ConnorRigby/underglow3/WiringHarness/resources/JST-SM-01x04-Male.png

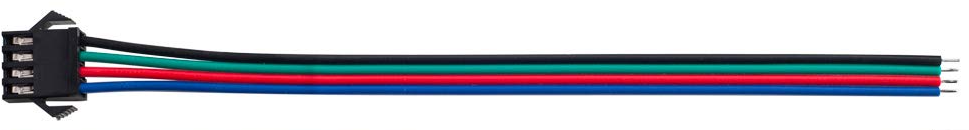
WiringHarness/resources/JST-SM-01x04-Male.png
