ConnorRigby/underglow3/WiringHarness/resources/Strip.png

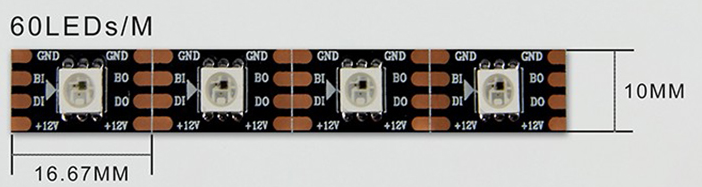
WiringHarness/resources/Strip.png
