ConnorRigby/underglow3/MainBoard/silk.png

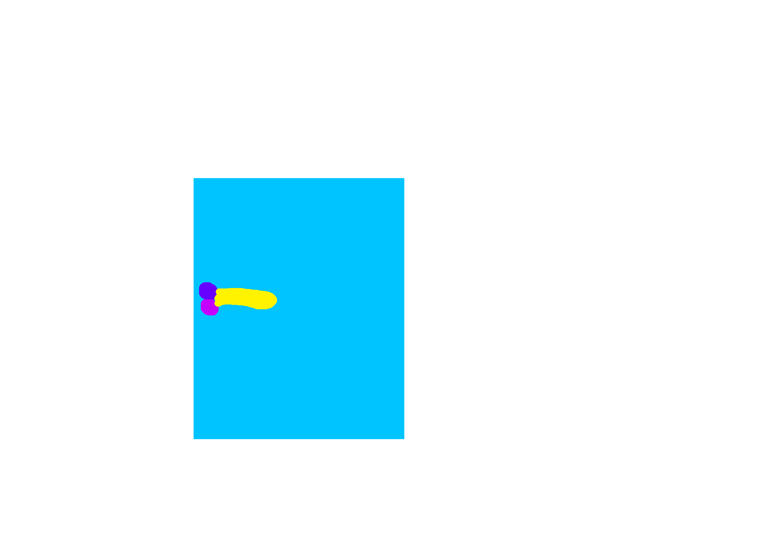
MainBoard/silk.png
