ConnorRigby/underglow3/MainBoard/underglow3-F_Silkscreen-1.png

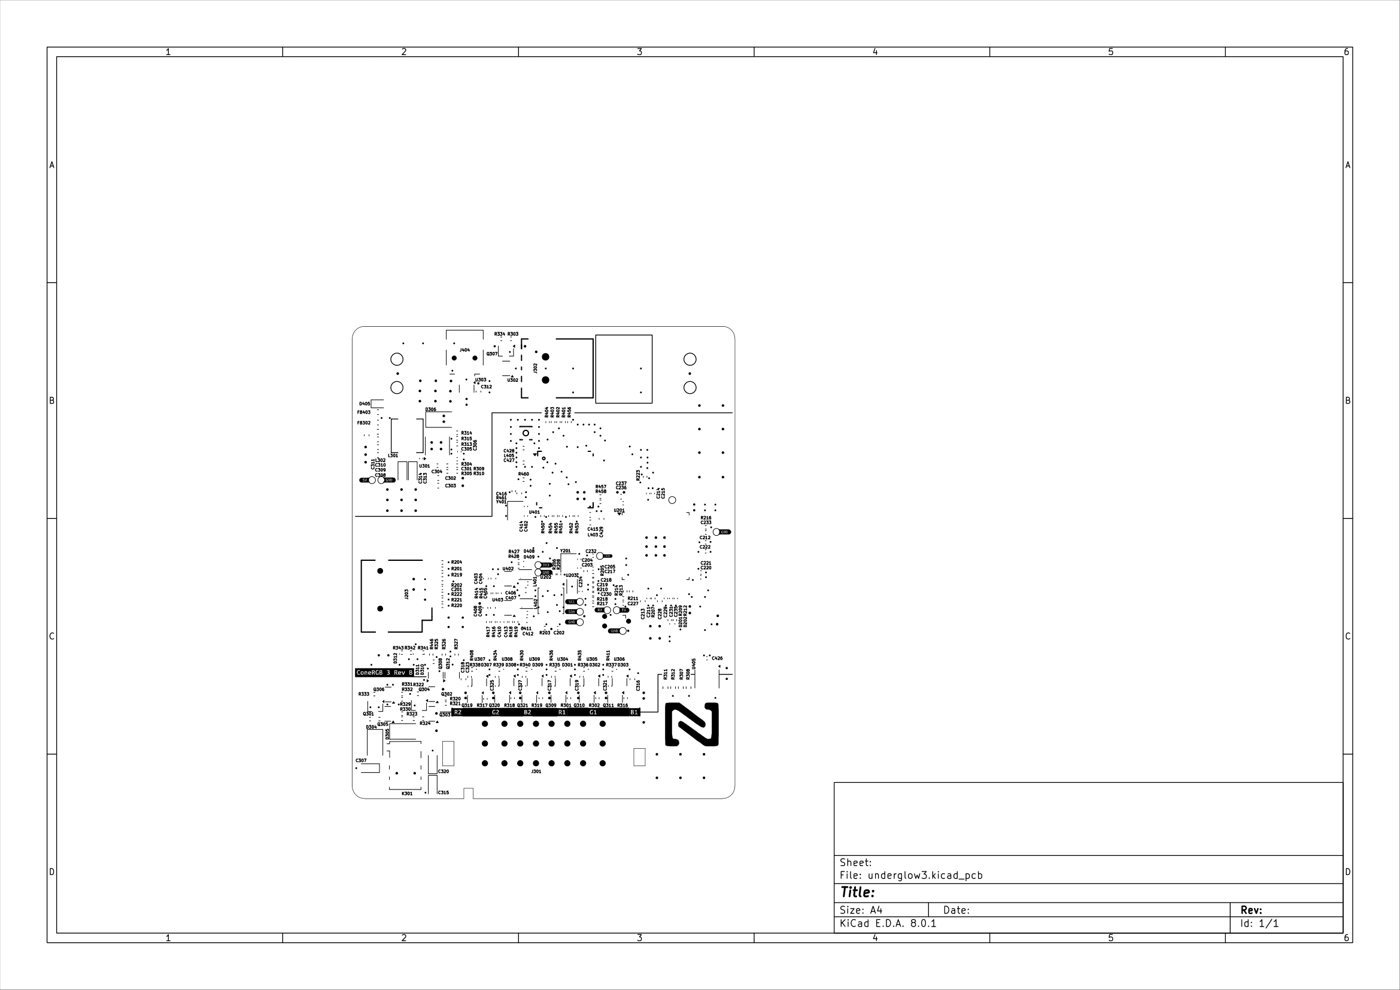
MainBoard/underglow3-F_Silkscreen-1.png
