ConnorRigby/underglow3/MainBoard/underglow3.png

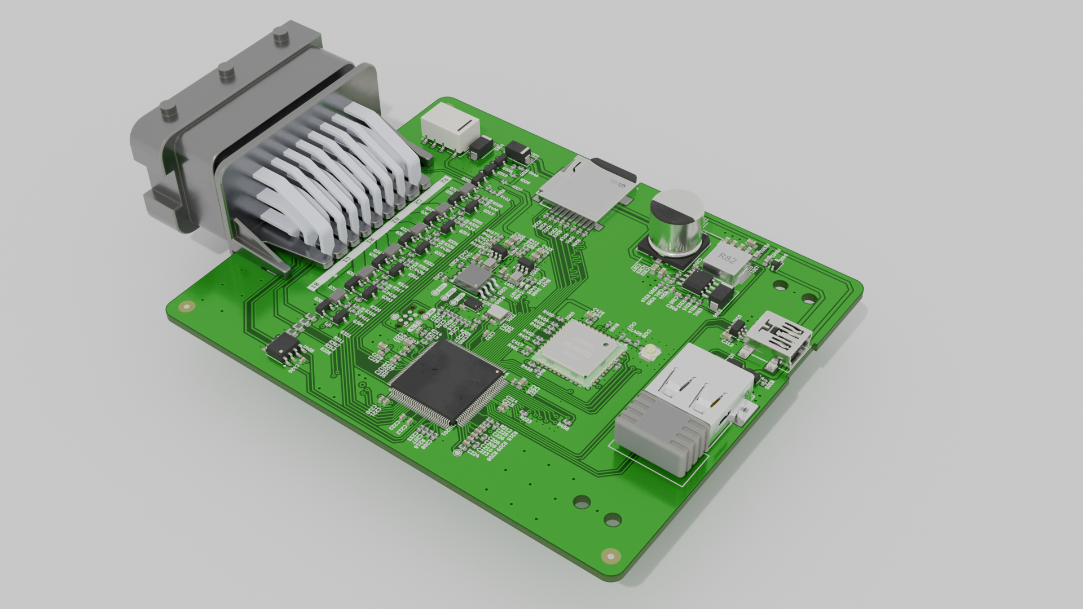
MainBoard/underglow3.png
