ConnorRigby/underglow3/WiringHarness/index.png

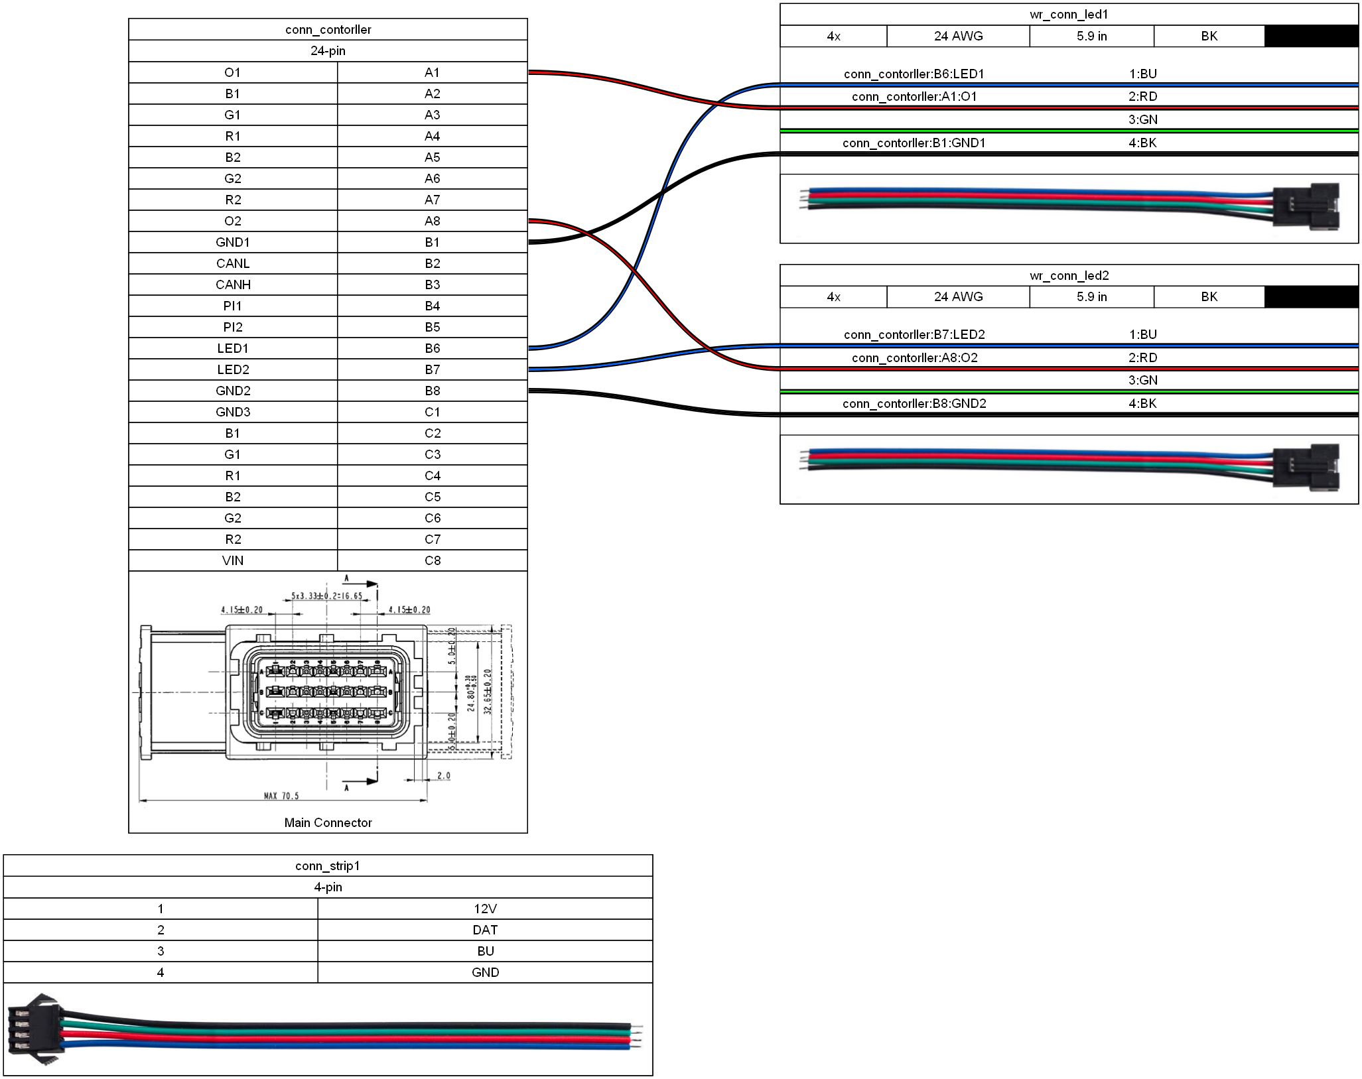
WiringHarness/index.png
