ConnorRigby/underglow3/WiringHarness/resources/211PC249S0005.png

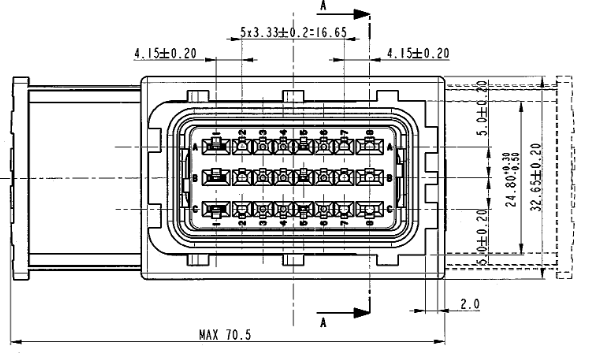
WiringHarness/resources/211PC249S0005.png
