ConnorRigby/underglow3/WiringHarness/resources/JST-SM-01-04-Ext.png

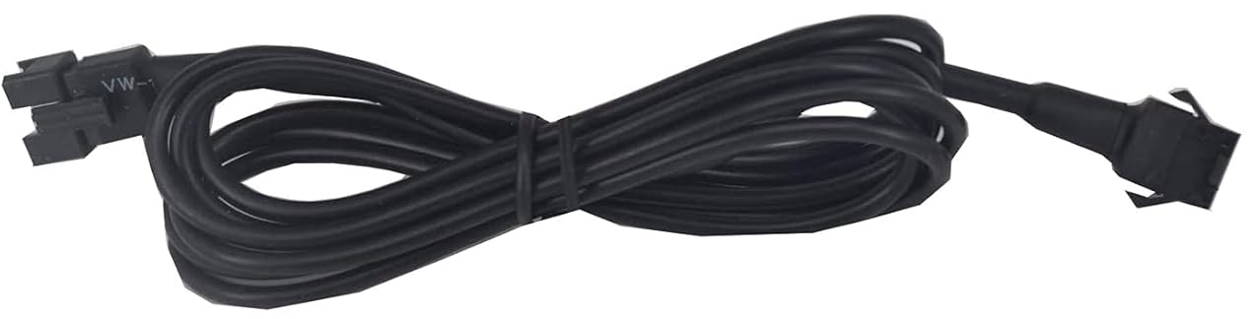
WiringHarness/resources/JST-SM-01-04-Ext.png
