ConnorRigby/underglow3/MainBoard/underglow3-Edge_Cuts.pdf

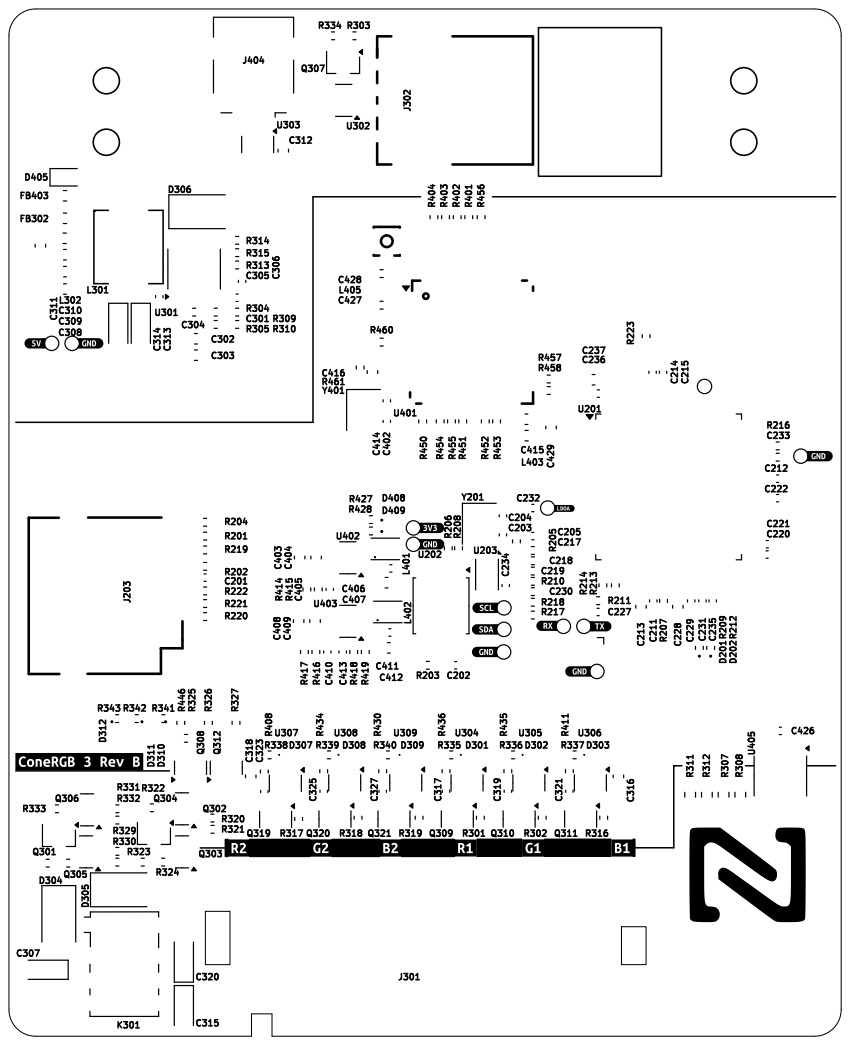
[picture p9: page 1]
