ConnorRigby/underglow3/MainBoard/underglow3-F_Silkscreen.pdf

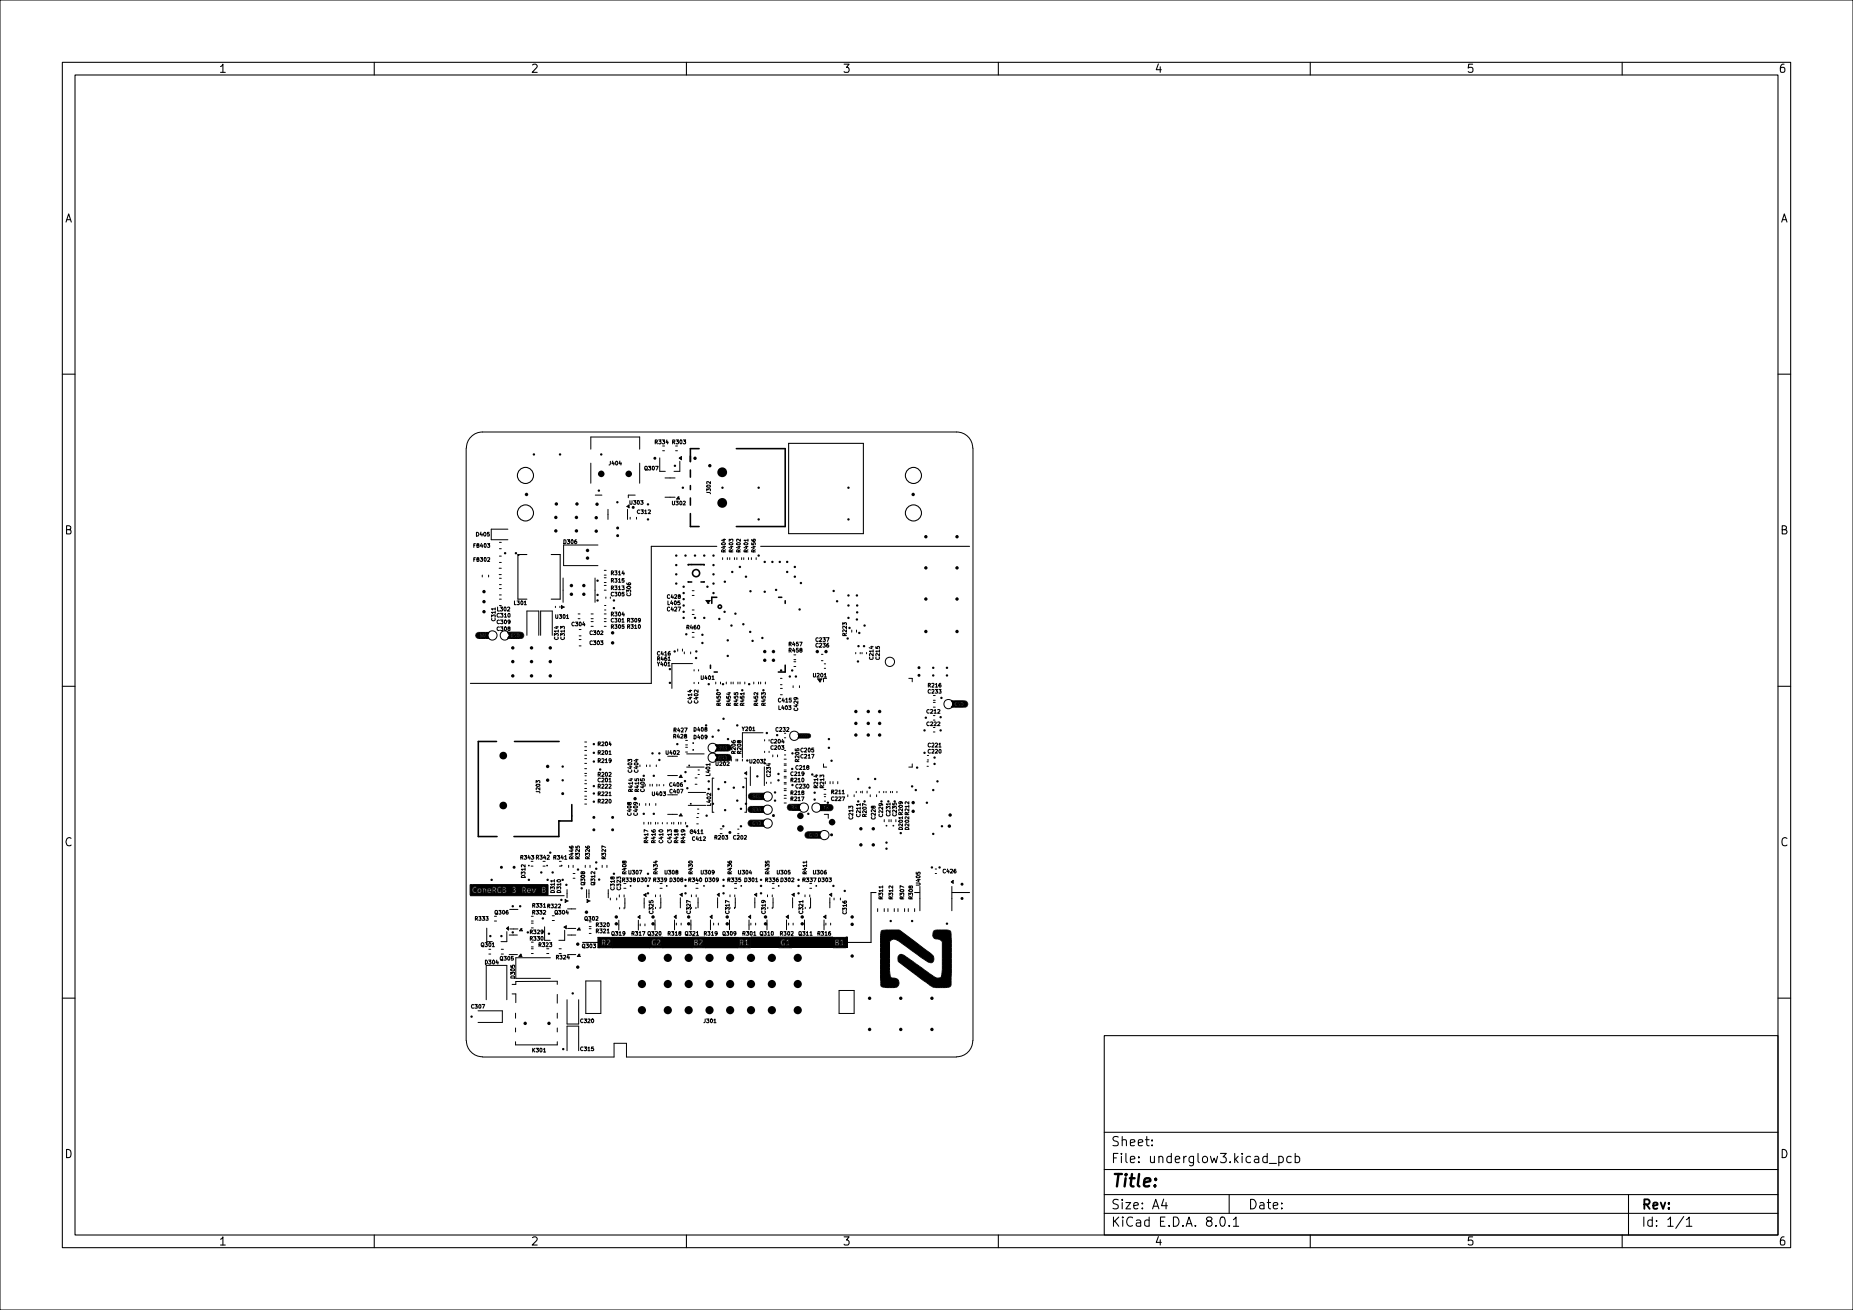
[picture p10: page 1]
