ConnorRigby/underglow3/MainBoard/underglow3.kicad_pcb

## KiCad design MainBoard/underglow3.kicad_pcb (2024-08-10)

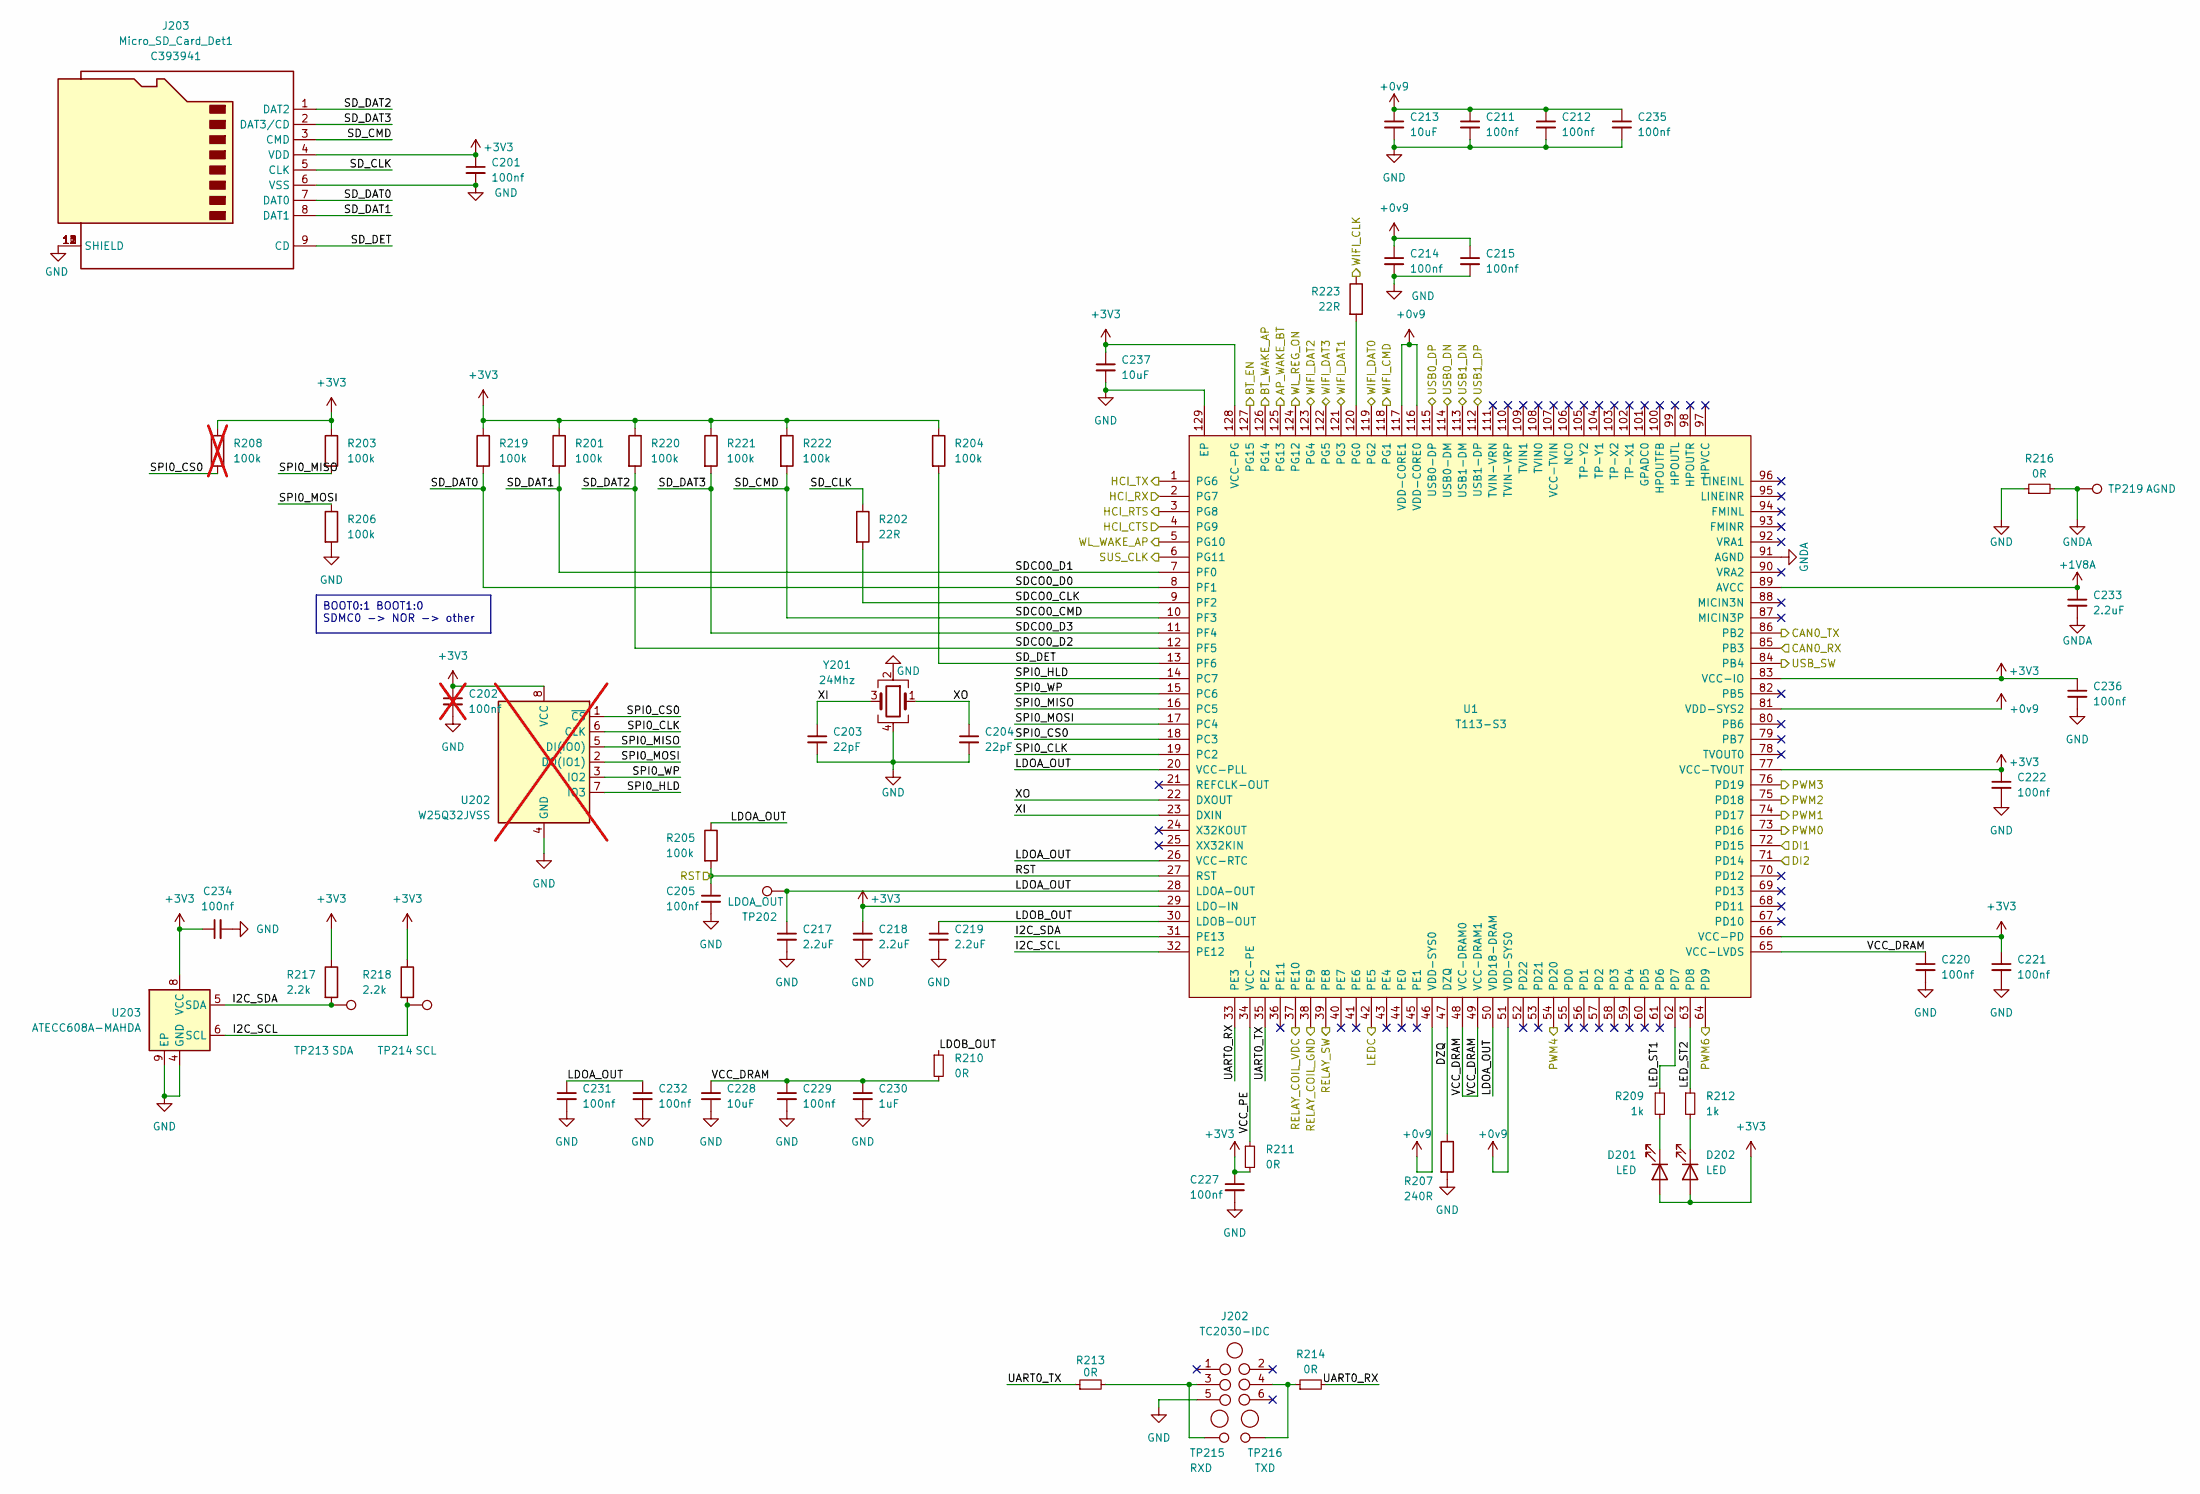
[picture p11: schematic T113-S3.kicad_sch]

Parts:
C201, C205, C211, C212, C214, C215, C220, C221, C222, C227, C229, C231, C232, C234, C235, C236: 100nf; C_0402_1005Metric; MPN CL05B104KB54PNC; LCSC C307331
C202: 100nf; C_0402_1005Metric; MPN CL05B104KB54PNC; LCSC C307331; not fitted
C203, C204: 22pF; C_0402_1005Metric; MPN 0402CG220J500NT; LCSC C1555
C213, C228, C237: 10uF; C_0603_1608Metric; MPN CL10A106MA8NRNC; LCSC C96446
C217, C218, C219, C233: 2.2uF; R_0402_1005Metric; MPN CL05A225MQ5NSNC; LCSC C12530
C230: 1uF; R_0402_1005Metric; MPN CL05A105KA5NQNC; LCSC C52923
D201, D202: LED; LED_0402_1005Metric; MPN LTST-C281KRKT; LCSC C364556
J202: TC2030-IDC; Tag-Connect_TC2030-IDC-NL_2x03_P1.27mm_Vertical; MPN TC2030-IDC
J203: Micro_SD_Card_Det1; TF-SMD_TF-PUSH; MPN TF PUSH; LCSC C393941
R201, R203, R204, R205, R206, R219, R220, R221, R222: 100k; R_0402_1005Metric; MPN 0402WGF1003TCE; LCSC C25741
R202, R223: 22R; R_0402_1005Metric; MPN 0402WGF220JTCE; LCSC C25092
R207: 240R; R_0402_1005Metric; MPN 0402WGF2400TCE; LCSC C25094
R208: 100k; R_0402_1005Metric; MPN 0402WGF1003TCE; LCSC C25741; not fitted
R209, R212: 1k; R_0402_1005Metric; MPN 0402WGF1001TCE; LCSC C11702
R210, R211, R213, R214, R216: 0R; R_0402_1005Metric; MPN 0402WGF0000TCE; LCSC C17168
R217, R218: 2.2k; R_0402_1005Metric; MPN 0402WGF2201TCE; LCSC C25879
TP202: LDOA_OUT; TestPoint_Pad_D1.0mm
TP213: SDA; TestPoint_Pad_D1.0mm
TP214: SCL; TestPoint_Pad_D1.0mm
TP215: RXD; TestPoint_Pad_D1.0mm
TP216: TXD; TestPoint_Pad_D1.0mm
TP219: AGND; TestPoint_Pad_D1.0mm
U1: T113-S3; LQFP-128_L14.0-W14.0-P0.40-LS16.0-BL-EP5.6; MPN T113-S3; LCSC C5197687
U202: W25Q32JVSS; SOIC-8_5.23x5.23mm_P1.27mm; MPN W25Q32JVSSIQ; LCSC C179173; not fitted
U203: ATECC608A-MAHDA; DFN-8-1EP_3x2mm_P0.5mm_EP1.3x1.5mm; MPN ATECC608A-MAHDA-S; LCSC C616908
Y201: 24Mhz; Crystal_SMD_3225-4Pin_3.2x2.5mm; MPN 3TJ424000XYFBC; LCSC C2149059

Connections:
+0v9: C211.1, C212.1, C213.1, C214.1, C215.1, C235.1; also elsewhere on the board
+1V8A: C233.1; also elsewhere on the board
+3V3: C201.1, C202.1, C218.1, C221.1, C222.1, C227.1, C234.1, C236.1, C237.1, D201.2 (A), D202.2 (A), J203.4 (VDD), R201.1, R203.1, R204.1, R208.1, R211.2, R217.1, R218.1, R219.1, R220.1, R221.1, R222.1, U202.8 (VCC), U203.8 (VCC); also elsewhere on the board
/Application/DZQ: R207.1; also elsewhere on the board
/Application/I2C_SCL: R218.2, TP214.1, U203.6 (SCL); also elsewhere on the board
/Application/I2C_SDA: R217.2, TP213.1, U203.5 (SDA); also elsewhere on the board
/Application/LDOA_OUT: C217.1, C231.1, C232.1, R205.1, TP202.1; also elsewhere on the board
/Application/LDOB_OUT: C219.1, R210.1; also elsewhere on the board
/Application/LED_ST1: R209.1; also elsewhere on the board
/Application/LED_ST2: R212.1; also elsewhere on the board
/Application/RST: C205.1, R205.2; also elsewhere on the board
/Application/SDCO0_CLK: R202.2; also elsewhere on the board
/Application/SDCO0_CMD: J203.3 (CMD), R222.2; also elsewhere on the board
/Application/SDCO0_D0: J203.7 (DAT0), R219.2; also elsewhere on the board
/Application/SDCO0_D1: J203.8 (DAT1), R201.2; also elsewhere on the board
/Application/SDCO0_D2: J203.1 (DAT2), R220.2; also elsewhere on the board
/Application/SDCO0_D3: J203.2 (DAT3/CD), R221.2; also elsewhere on the board
/Application/SD_CLK: J203.5 (CLK), R202.1
/Application/SD_DET: J203.9 (CD), R204.2; also elsewhere on the board
/Application/SPI0_CLK: U202.6 (CLK); also elsewhere on the board
/Application/SPI0_CS0: R208.2, U202.1 (~CS); also elsewhere on the board
/Application/SPI0_HLD: U202.7 (IO3); also elsewhere on the board
/Application/SPI0_MISO: R203.2, U202.5 (DI(IO0)); also elsewhere on the board
/Application/SPI0_MOSI: R206.1, U202.2 (DO(IO1)); also elsewhere on the board
/Application/SPI0_WP: U202.3 (IO2); also elsewhere on the board
/Application/UART0_RX: R214.2; also elsewhere on the board
/Application/UART0_TX: R213.1; also elsewhere on the board
/Application/VCC_DRAM: C220.1, C228.1, C229.1, C230.1, R210.2; also elsewhere on the board
/Application/VCC_PE: R211.1; also elsewhere on the board
/Application/WIFI_CLK: R223.1; also elsewhere on the board
/Application/XI: C203.1, Y201.3; also elsewhere on the board
/Application/XO: C204.1, Y201.1; also elsewhere on the board
GND: C201.2, C202.2, C203.2, C204.2, C205.2, C211.2, C212.2, C213.2, C214.2, C215.2, C217.2, C218.2, C219.2, C220.2, C221.2, C222.2, C227.2, C228.2, C229.2, C230.2, C231.2, C232.2, C234.2, C235.2, C236.2, C237.2, J202.5, J203.6 (VSS), J203.10 (SHIELD), J203.11 (SHIELD), J203.12 (SHIELD), J203.13 (SHIELD), R206.2, R207.2, R216.1, U202.4 (GND), U203.4 (GND), U203.9 (EP), Y201.2, Y201.4; also elsewhere on the board
GNDA: C233.2, R216.2, TP219.1; also elsewhere on the board
unnamed: D201.1 (K), R209.2
unnamed: D202.1 (K), R212.2
unnamed: J202.3, R213.2, TP215.1
unnamed: J202.4, R214.1, TP216.1
unnamed 130: R223.2; also elsewhere on the board

Notes on the sheet:
BOOT0:1 BOOT1:0 SDMC0 -> NOR -> other

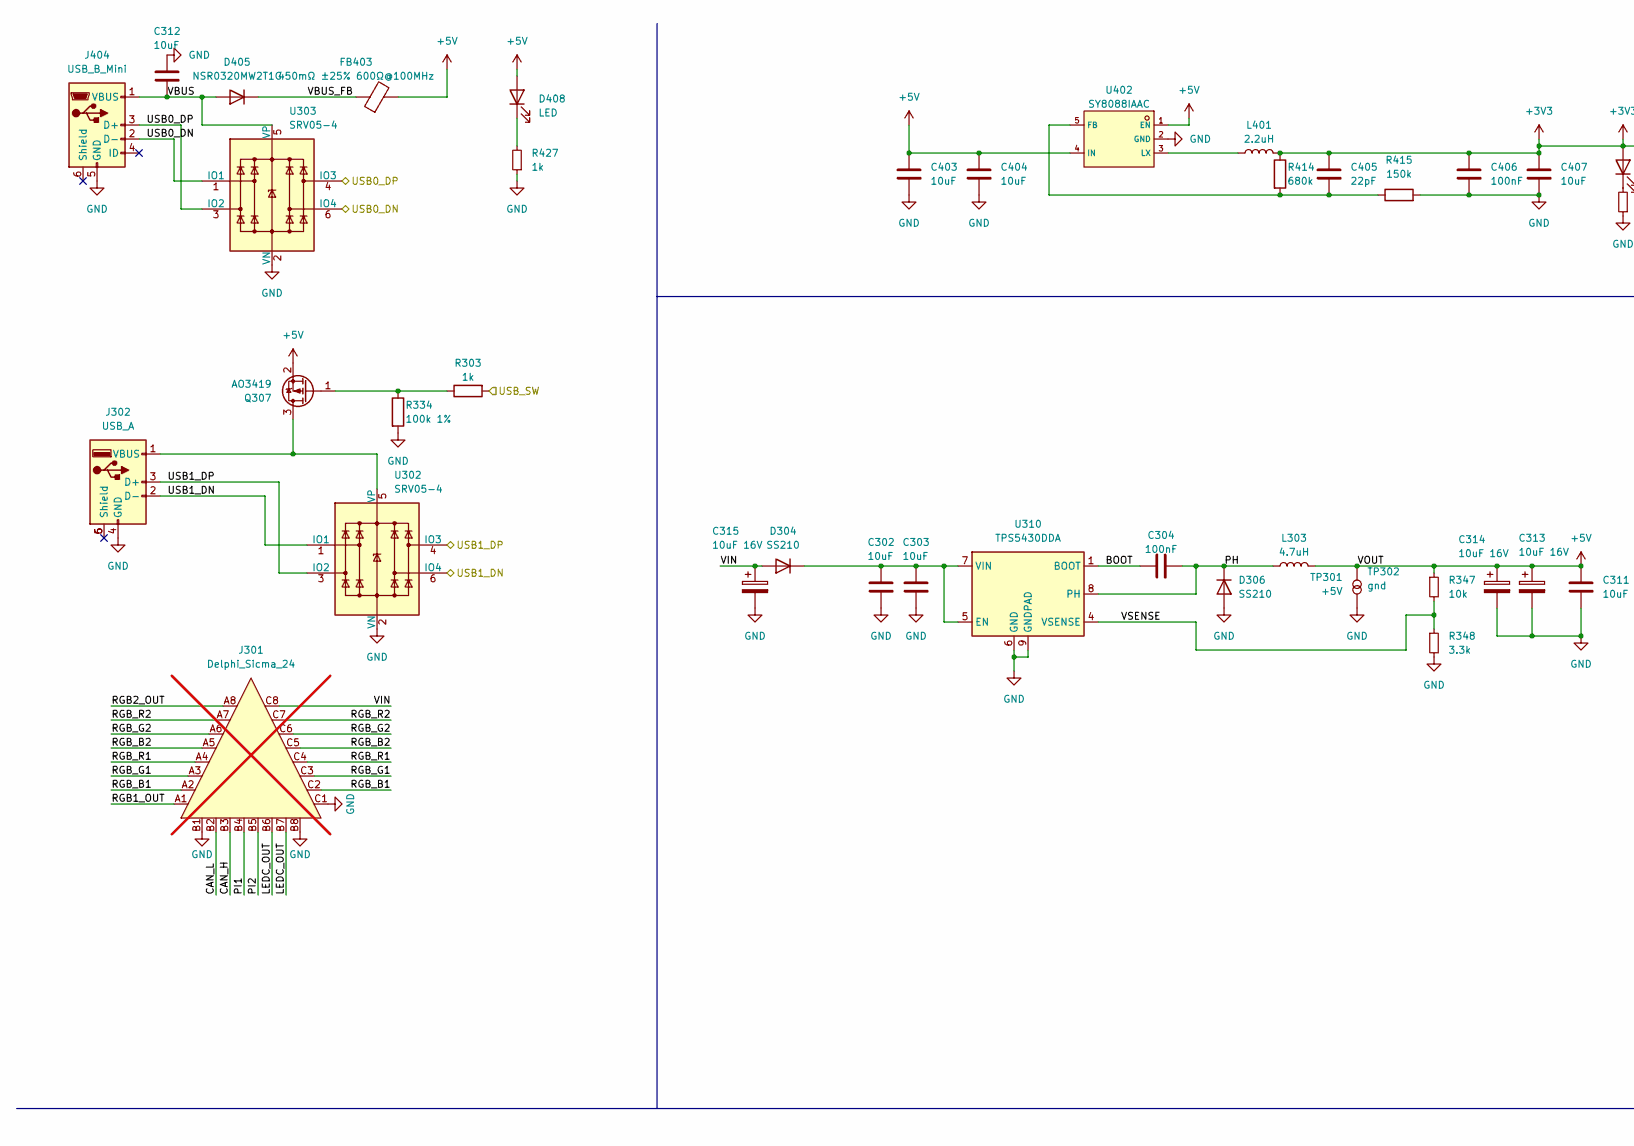
[picture p12: schematic Power.kicad_sch, part in row 1, column 1]

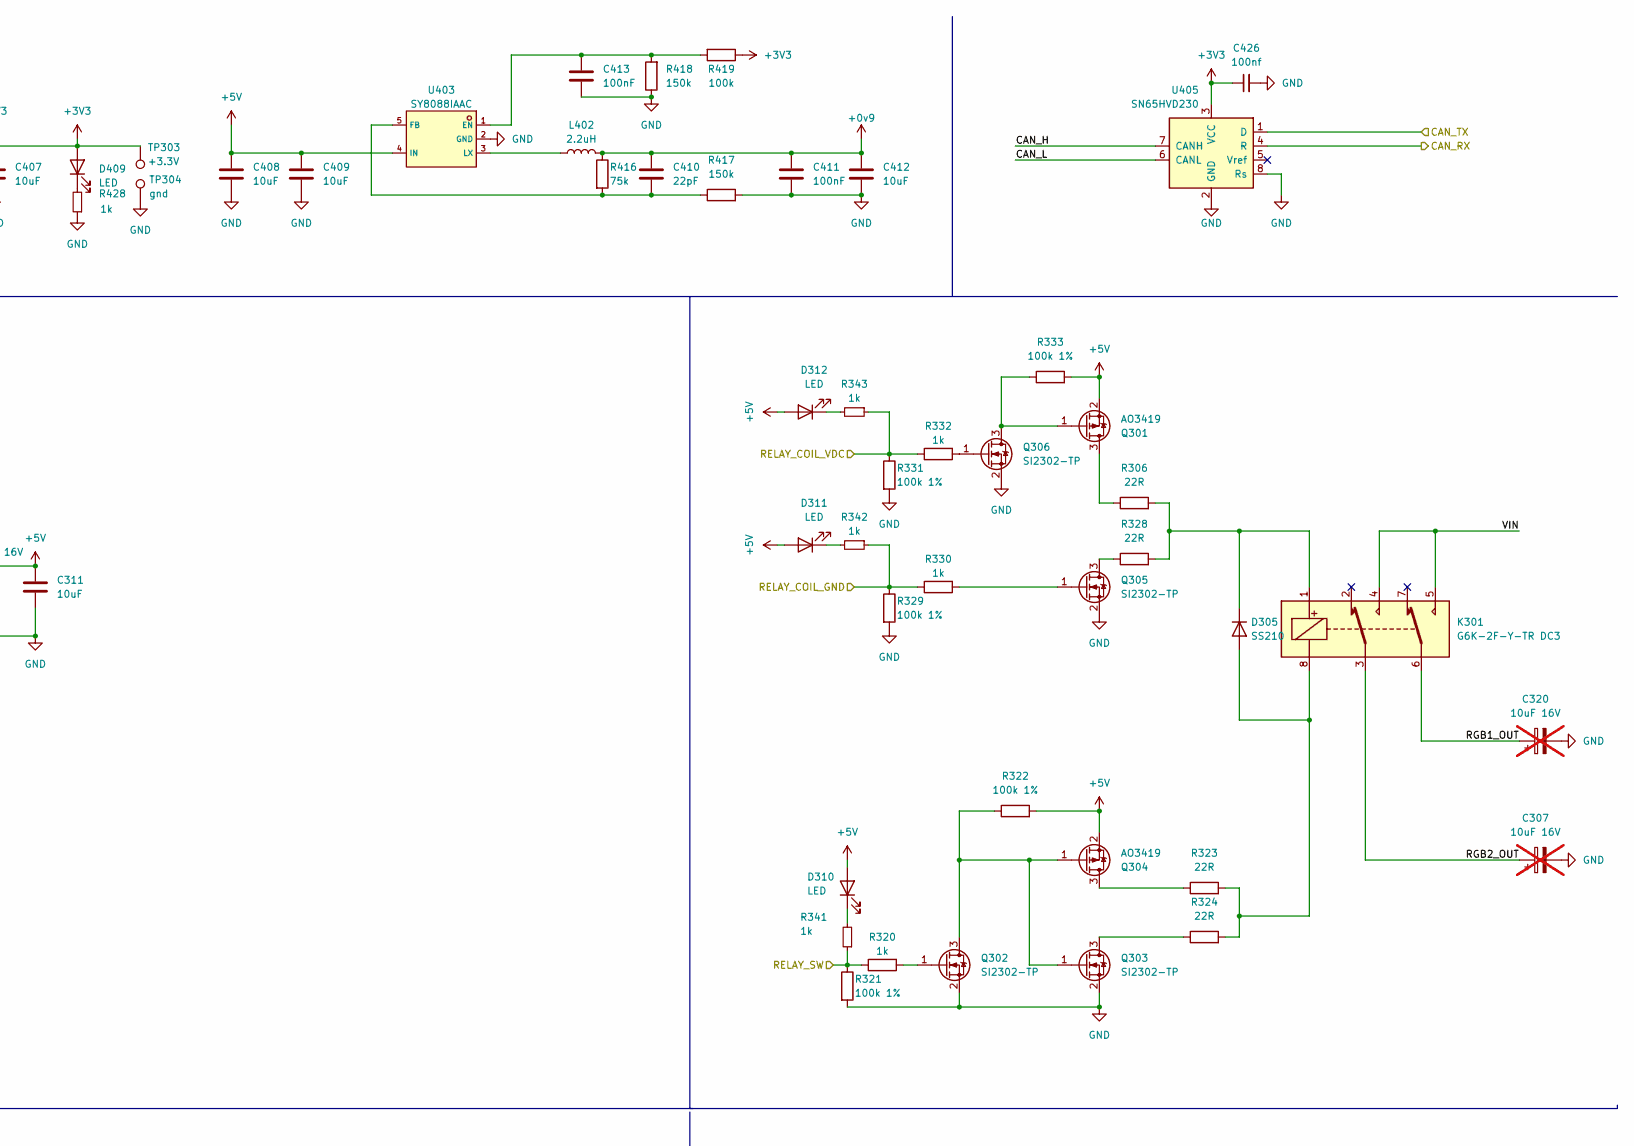
[picture p13: schematic Power.kicad_sch, part in row 1, column 2]

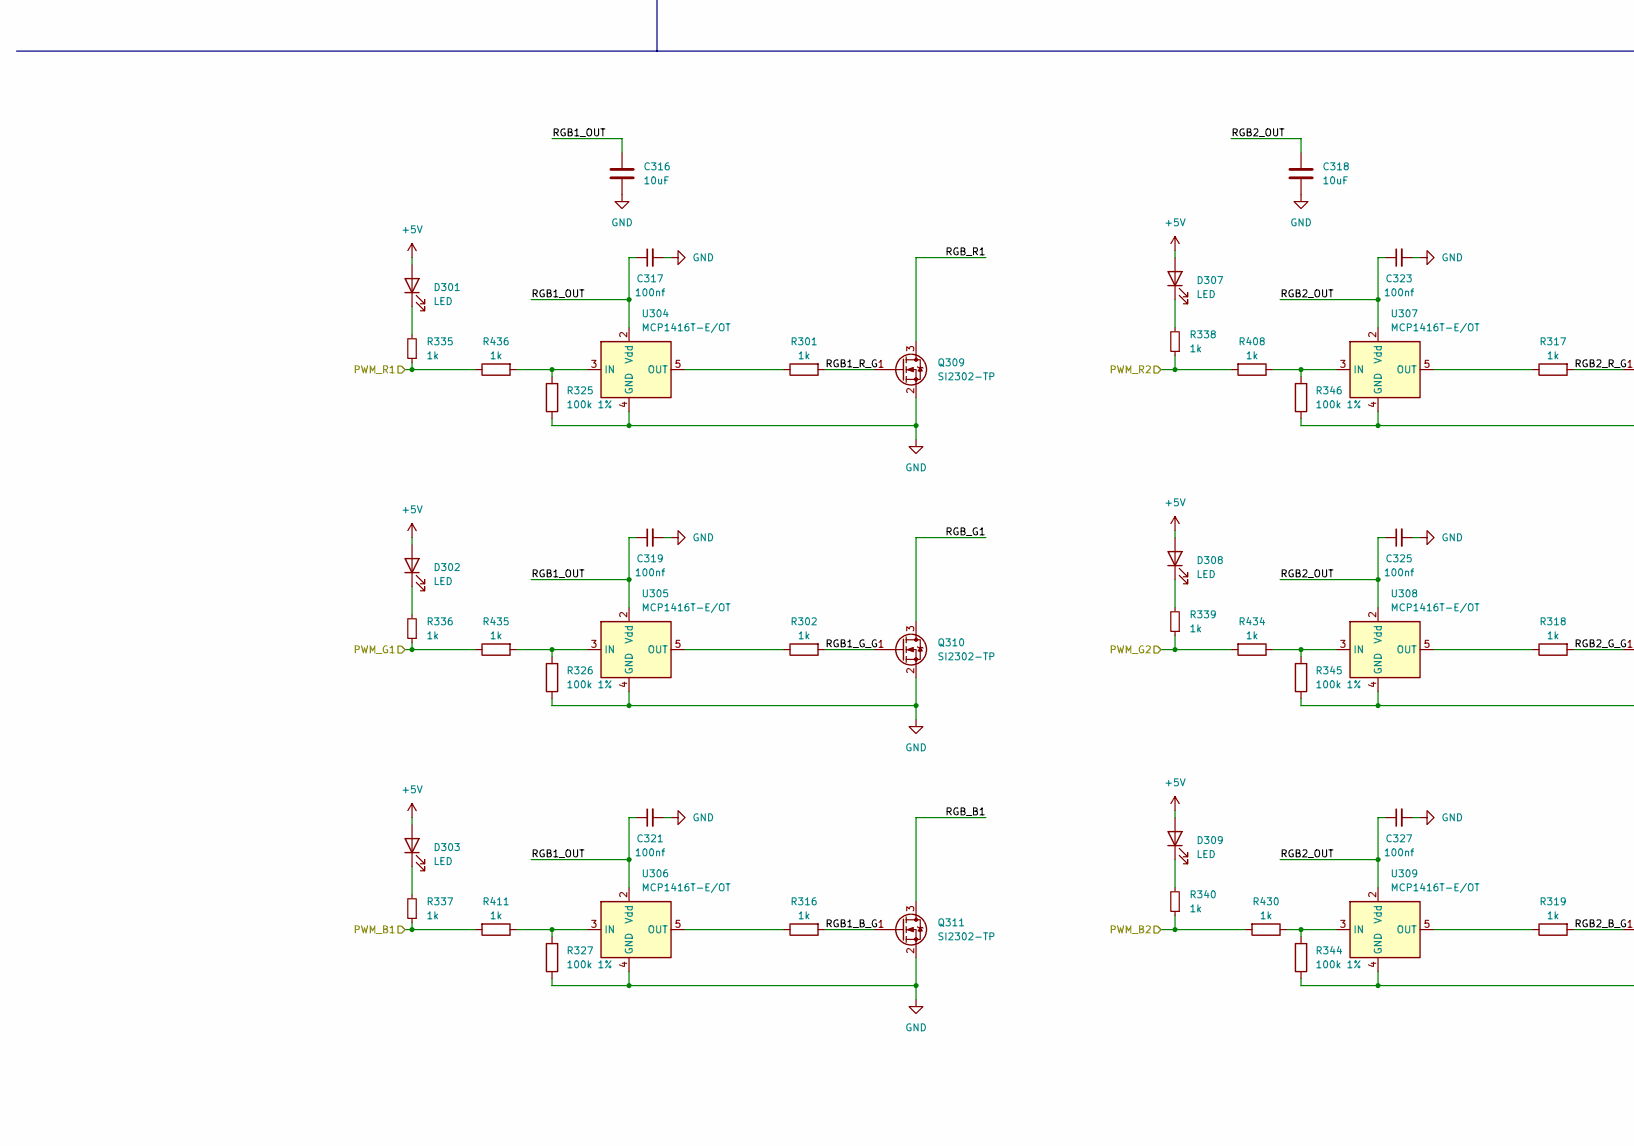
[picture p14: schematic Power.kicad_sch, part in row 2, column 1]

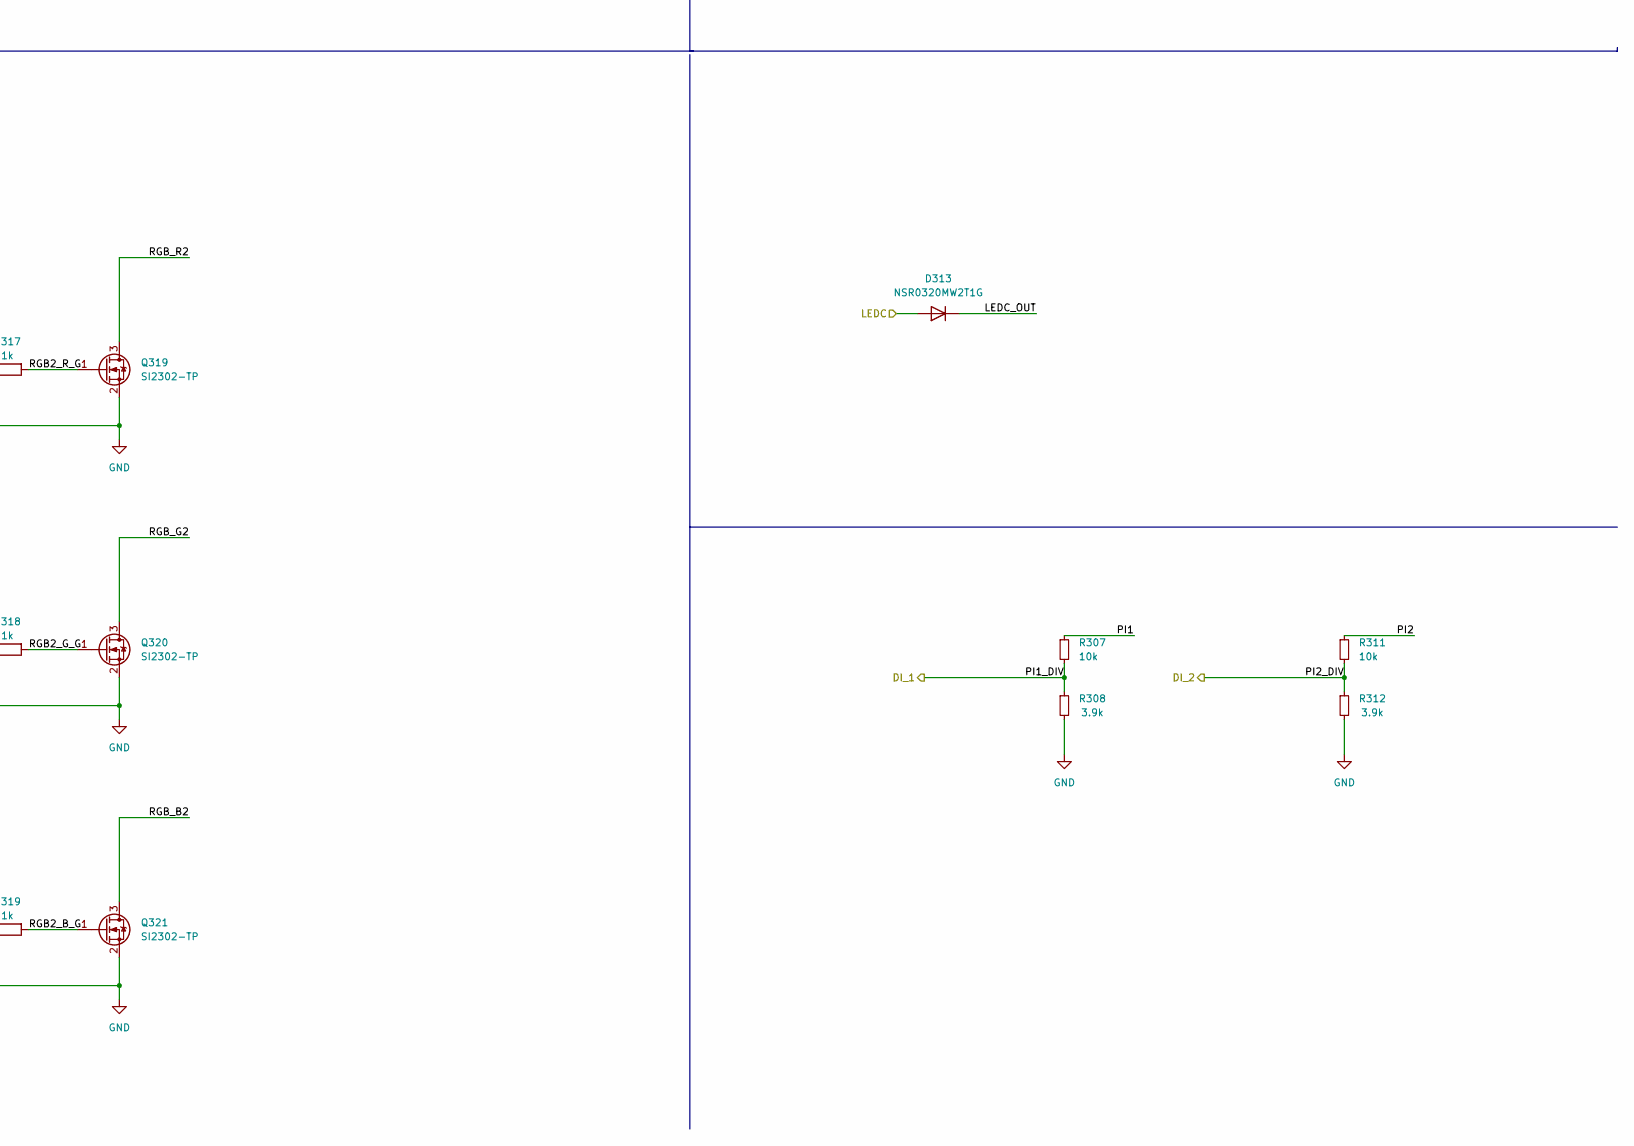
[picture p15: schematic Power.kicad_sch, part in row 2, column 2]

Parts:
C302, C303, C311, C312: 10uF; C_0603_1608Metric; MPN CL10A106MA8NRNC; LCSC C96446
C304, C406, C411, C413: 100nF; C_0402_1005Metric; MPN CL05B104KB54PNC; LCSC C307331
C307, C320: 10uF 16V; CP_EIA-3216-18_Kemet-A; MPN TAJA106K016RNJ; LCSC C7171; not fitted
C313, C314, C315: 10uF 16V; CP_EIA-3216-18_Kemet-A; MPN TAJA106K016RNJ; LCSC C7171
C316, C318, C403, C404, C407, C408, C409, C412: 10uF; C_0603_1608Metric; MPN CL10A106KP8NNNC; LCSC C19702
C317, C319, C321, C323, C325, C327, C426: 100nf; C_0402_1005Metric; MPN CL05B104KB54PNC; LCSC C307331
C405, C410: 22pF; C_0402_1005Metric; MPN 0402CG220J500NT; LCSC C1555
D301, D302, D303, D307, D308, D309, D310, D311, D312, D408, D409: LED; LED_0402_1005Metric; MPN LTST-C281KRKT; LCSC C364556
D304, D305, D306: SS210; D_SMA; MPN SS210; LCSC C14996
D313, D405: NSR0320MW2T1G; D_SOD-323; MPN 1N5819WS; LCSC C191023
FB403: 450mΩ ±25% 600Ω@100MHz; L_0603_1608Metric; MPN GZ1608D601TF; LCSC C1002
J301: Delphi_Sicma_24; Delphi_Sicma_24_Black; MPN Delphi_Sicma_24; not fitted
J302: USB_A; USB-A-SMD_USB-234-BCW; MPN USB-234-BCW; LCSC C720528
J404: USB_B_Mini; USB_Mini-B_Lumberg_2486_01_Horizontal; MPN UX-144S-ACP5; LCSC C720611
K301: G6K-2F-Y-TR DC3; Relay_DPDT_Omron_G6K-2F-Y; MPN G6K-2F-Y-TR DC3; LCSC C2153097
L303: 4.7uH; IND-SMD_L7.3-W7.3; MPN CD105-4R7M 4.7UH; LCSC C2826710
L401, L402: 2.2uH; IND-SMD_L2.0-W1.6_VLS201610CX-150M; MPN WPN201610H2R2MT; LCSC C97005
Q301, Q304, Q307: AO3419; SOT-23W; MPN AO3419; LCSC C88053
Q302, Q303, Q305, Q306: SI2302-TP; SOT-23; MPN SI2302-TP; LCSC C77977
Q309, Q310, Q311, Q319, Q320, Q321: SI2302-TP; SOT-23-3; MPN AO3400A; LCSC C20917
R301, R302, R303, R316, R317, R318, R319, R320, R330, R332, R335, R336, R337, R338, R339, R340, R341, R342, R343, R408, R411, R427, R428, R430, R434, R435, R436: 1k; R_0402_1005Metric; MPN 0402WGF1001TCE; LCSC C11702
R306, R323, R324, R328: 22R; R_0402_1005Metric; MPN 0402WGF220JTCE; LCSC C25092
R307, R311, R347: 10k; R_0402_1005Metric; MPN 0402WGF1002TCE; LCSC C25744
R308, R312: 3.9k; R_0402_1005Metric; MPN 0402WGF3901TCE; LCSC C51721
R321, R322, R325, R326, R327, R329, R331, R333, R334, R344, R345, R346: 100k 1%; R_0402_1005Metric; MPN 0402WGF1003TCE; LCSC C25741
R348: 3.3k; R_0402_1005Metric; MPN 0402WGF3301TCE; LCSC C25890
R414: 680k; R_0402_1005Metric; MPN 0402WGF6803TCE; LCSC C4131
R415, R417, R418: 150k; R_0402_1005Metric; MPN 0402WGF1503TCE; LCSC C25755
R416: 75k; R_0402_1005Metric; MPN 0402WGF7502TCE; LCSC C25798
R419: 100k; R_0402_1005Metric; MPN 0402WGF1003TCE; LCSC C25741
TP301: +5V; TestPoint_Pad_D1.0mm
TP302, TP304: gnd; TestPoint_Pad_D1.0mm
TP303: +3.3V; TestPoint_Pad_D1.0mm
U302, U303: SRV05-4; SOT-23-6; MPN SRV05-4; LCSC C7420376
U304, U305, U306, U307, U308, U309: MCP1416T-E/OT; SOT-23-5; MPN MCP1416T-E/OT; LCSC C83775
U310: TPS5430DDA; TI_SO-PowerPAD-8_ThermalVias; MPN TPS5430DDA; LCSC C9864
U402, U403: SY8088IAAC; SOT-23-5; MPN SY8088IAAC; LCSC C479072
U405: SN65HVD230; SOIC-8_3.9x4.9mm_P1.27mm; MPN SN65HVD230DR; LCSC C12084

Connections:
+0v9: C410.1, C411.1, C412.1, L402.2, R416.1; also elsewhere on the board
+3V3: C405.1, C406.1, C407.1, C426.1, D409.2 (A), L401.2, R414.1, R419.1, TP303.1, U405.3 (VCC); also elsewhere on the board
+5V: C311.1, C313.1, C314.1, C403.1, C404.1, C408.1, C409.1, D301.2 (A), D302.2 (A), D303.2 (A), D307.2 (A), D308.2 (A), D309.2 (A), D310.2 (A), D311.2 (A), D312.2 (A), D408.2 (A), FB403.2, L303.2, Q301.2 (S), Q304.2 (S), Q307.2 (S), R322.2, R333.2, R347.1, TP301.1, U402.1 (EN), U402.4 (IN), U403.4 (IN)
/Application/CAN0_RX: U405.4 (R); also elsewhere on the board
/Application/CAN0_TX: U405.1 (D); also elsewhere on the board
/Application/LEDC: D313.2 (A); also elsewhere on the board
/Application/PWM0: R340.1, R430.2; also elsewhere on the board
/Application/PWM1: R335.1, R436.1; also elsewhere on the board
/Application/PWM2: R336.1, R435.1; also elsewhere on the board
/Application/PWM3: R337.1, R411.2; also elsewhere on the board
/Application/PWM4: R338.1, R408.2; also elsewhere on the board
/Application/PWM6: R339.1, R434.2; also elsewhere on the board
/Application/RELAY_COIL_GND: R329.1, R330.1, R342.1; also elsewhere on the board
/Application/RELAY_COIL_VDC: R331.1, R332.1, R343.1; also elsewhere on the board
/Application/RELAY_SW: R320.1, R321.1, R341.1; also elsewhere on the board
/Application/USB_SW: R303.2; also elsewhere on the board
/Power/BOOT: C304.1, U310.1 (BOOT)
/Power/CAN_H: J301.B3, U405.7 (CANH)
/Power/CAN_L: J301.B2, U405.6 (CANL)
/Power/LEDC_OUT: D313.1 (K), J301.B6, J301.B7
/Power/PH: C304.2, D306.1 (K), L303.1, U310.8 (PH)
/Power/PI1: J301.B4, R307.1
/Power/PI1_DIV: R307.2, R308.1; also elsewhere on the board
/Power/PI2: J301.B5, R311.1
/Power/PI2_DIV: R311.2, R312.1; also elsewhere on the board
/Power/RGB1_B_G: Q311.1 (G), R316.2
/Power/RGB1_G_G: Q310.1 (G), R302.2
/Power/RGB1_OUT: C316.1, C317.1, C319.1, C320.1, C321.1, J301.A1, K301.6, U304.2 (Vdd), U305.2 (Vdd), U306.2 (Vdd)
/Power/RGB1_R_G: Q309.1 (G), R301.2
/Power/RGB2_B_G: Q321.1 (G), R319.2
/Power/RGB2_G_G: Q320.1 (G), R318.2
/Power/RGB2_OUT: C307.1, C318.1, C323.1, C325.1, C327.1, J301.A8, K301.3, U307.2 (Vdd), U308.2 (Vdd), U309.2 (Vdd)
/Power/RGB2_R_G: Q319.1 (G), R317.2
/Power/RGB_B1: J301.A2, J301.C2, Q311.3 (D)
/Power/RGB_B2: J301.A5, J301.C5, Q321.3 (D)
/Power/RGB_G1: J301.A3, J301.C3, Q310.3 (D)
/Power/RGB_G2: J301.A6, J301.C6, Q320.3 (D)
/Power/RGB_R1: J301.A4, J301.C4, Q309.3 (D)
/Power/RGB_R2: J301.A7, J301.C7, Q319.3 (D)
/Power/USB0_DN: J404.2 (D-), U303.1 (IO1), U303.6 (IO4); also elsewhere on the board
/Power/USB0_DP: J404.3 (D+), U303.3 (IO2), U303.4 (IO3); also elsewhere on the board
/Power/USB1_DN: J302.2 (D-), U302.1 (IO1), U302.6 (IO4); also elsewhere on the board
/Power/USB1_DP: J302.3 (D+), U302.3 (IO2), U302.4 (IO3); also elsewhere on the board
/Power/VBUS: C312.2, D405.2 (A), J404.1 (VBUS), U303.5 (VP)
/Power/VBUS_FB: D405.1 (K), FB403.1
/Power/VIN: C315.1, D304.2 (A), J301.C8, K301.4, K301.5
/Power/VSENSE: R347.2, R348.1, U310.4 (VSENSE)
GND: C302.2, C303.2, C307.2, C311.2, C312.1, C313.2, C314.2, C315.2, C316.2, C317.2, C318.2, C319.2, C320.2, C321.2, C323.2, C325.2, C327.2, C403.2, C404.2, C406.2, C407.2, C408.2, C409.2, C411.2, C412.2, C413.2, C426.2, D306.2 (A), J301.B1, J301.B8, J301.C1, J302.4 (GND), J404.5 (GND), Q302.2 (S), Q303.2 (S), Q305.2 (S), Q306.2 (S), Q309.2 (S), Q310.2 (S), Q311.2 (S), Q319.2 (S), Q320.2 (S), Q321.2 (S), R308.2, R312.2, R321.2, R325.1, R326.1, R327.1, R329.2, R331.2, R334.2, R344.1, R345.1, R346.1, R348.2, R415.2, R417.2, R418.1, R427.1, R428.1, TP302.1, TP304.1, U302.2 (VN), U303.2 (VN), U304.4 (GND), U305.4 (GND), U306.4 (GND), U307.4 (GND), U308.4 (GND), U309.4 (GND), U310.6 (GND), U310.9 (GNDPAD), U402.2 (GND), U403.2 (GND), U405.2 (GND), U405.8 (Rs); also elsewhere on the board
unnamed: D301.1 (K), R335.2
unnamed: D302.1 (K), R336.2
unnamed: D303.1 (K), R337.2
unnamed: C302.1, C303.1, D304.1 (K), U310.5 (EN), U310.7 (VIN)
unnamed: D305.2 (A), K301.8, R323.2, R324.2
unnamed: D305.1 (K), K301.1, R306.2, R328.2
unnamed: D307.1 (K), R338.2
unnamed: D308.1 (K), R339.2
unnamed: D309.1 (K), R340.2
unnamed: D310.1 (K), R341.2
unnamed: D311.1 (K), R342.2
unnamed: D312.1 (K), R343.2
unnamed: D408.1 (K), R427.2
unnamed: D409.1 (K), R428.2
unnamed: J302.1 (VBUS), Q307.3 (D), U302.5 (VP)
unnamed: Q301.3 (D), R306.1
unnamed: Q301.1 (G), Q306.3 (D), R333.1
unnamed: Q302.3 (D), Q303.1 (G), Q304.1 (G), R322.1
unnamed: Q302.1 (G), R320.2
unnamed: Q303.3 (D), R324.1
unnamed: Q304.3 (D), R323.1
unnamed: Q305.3 (D), R328.1
unnamed: Q305.1 (G), R330.2
unnamed: Q306.1 (G), R332.2
unnamed: Q307.1 (G), R303.1, R334.1
unnamed: R325.2, R436.2, U304.3 (IN)
unnamed: R301.1, U304.5 (OUT)
unnamed: R326.2, R435.2, U305.3 (IN)
unnamed: R302.1, U305.5 (OUT)
unnamed: R327.2, R411.1, U306.3 (IN)
unnamed: R316.1, U306.5 (OUT)
unnamed: R346.2, R408.1, U307.3 (IN)
unnamed: R317.1, U307.5 (OUT)
unnamed: R345.2, R434.1, U308.3 (IN)
unnamed: R318.1, U308.5 (OUT)
unnamed: R344.2, R430.1, U309.3 (IN)
unnamed: R319.1, U309.5 (OUT)
unnamed: C405.2, R414.2, R415.1, U402.5 (FB)
unnamed: L401.1, U402.3 (LX)
unnamed: C413.1, R418.2, R419.2, U403.1 (EN)
unnamed: C410.2, R416.2, R417.1, U403.5 (FB)
unnamed: L402.1, U403.3 (LX)

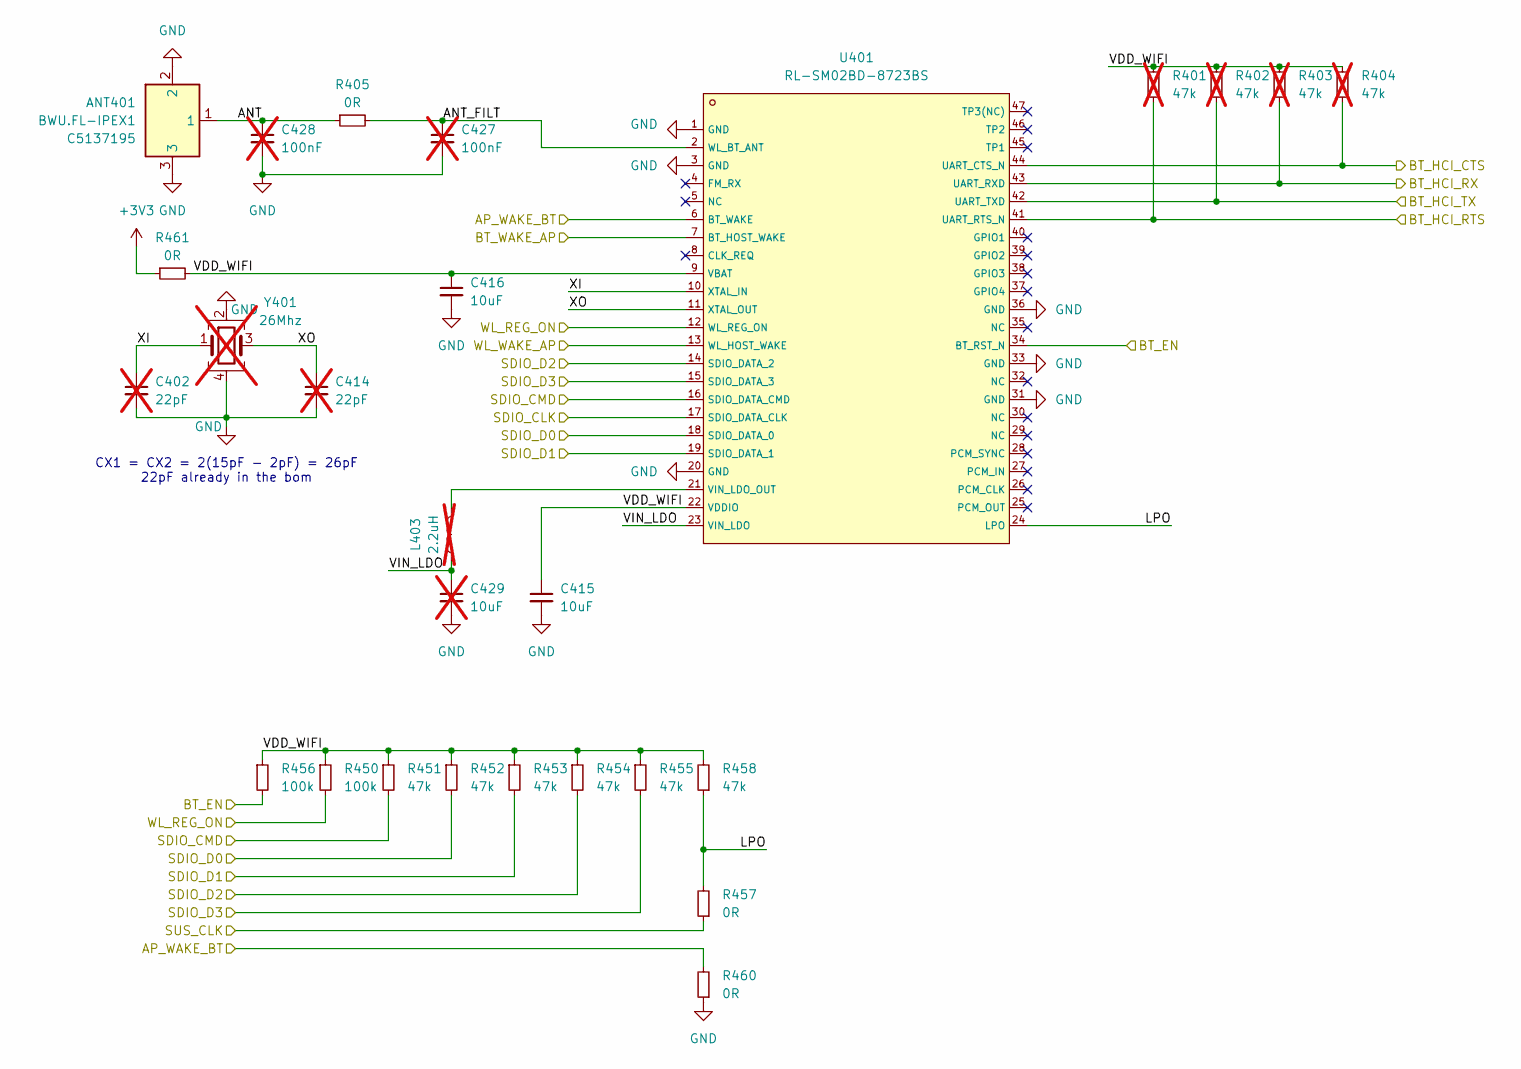
[picture p16: schematic RL-SM02BD-8723BS.kicad_sch]

Parts:
ANT401: BWU.FL-IPEX1; IPEX-SMD_BWIPX-1-001E; MPN BWU.FL-IPEX1; LCSC C5137195
C402, C414: 22pF; C_0402_1005Metric; MPN 0402CG220J500NT; LCSC C1555; not fitted
C415, C416: 10uF; C_0603_1608Metric; MPN CL10A106MA8NRNC; LCSC C96446
C427, C428: 100nF; R_0402_1005Metric; MPN CL05B104KB54PNC; LCSC C307331; not fitted
C429: 10uF; C_0603_1608Metric; MPN CL10A106MA8NRNC; LCSC C96446; not fitted
L403: 2.2uH; L_0603_1608Metric; MPN CPY160808T-2R2M-NP; LCSC C365953; not fitted
R401, R402, R403, R404: 47k; R_0402_1005Metric; MPN 0402WGF4702TCE; LCSC C25792; not fitted
R405, R457, R460, R461: 0R; R_0402_1005Metric; MPN 0402WGF0000TCE; LCSC C17168
R450, R456: 100k; R_0402_1005Metric; MPN 0402WGF1003TCE; LCSC C25741
R451, R452, R453, R454, R455, R458: 47k; R_0402_1005Metric; MPN 0402WGF4702TCE; LCSC C25792
U401: RL-SM02BD-8723BS; QFN-44_L12.0-W12.0-P0.90-TL_AP6212; MPN RL-SM02BD-8723BS; LCSC C9900101851
Y401: 26Mhz; Crystal_SMD_3225-4Pin_3.2x2.5mm; MPN TAXM26M4RHBCCT2T; LCSC C516065; not fitted

Connections:
+3V3: R461.1; also elsewhere on the board
/Application/AP_WAKE_BT: R460.2, U401.6 (BT_WAKE); also elsewhere on the board
/Application/BT_EN: R456.2, U401.34 (BT_RST_N); also elsewhere on the board
/Application/BT_WAKE_AP: U401.7 (BT_HOST_WAKE); also elsewhere on the board
/Application/HCI_CTS: R401.2, U401.41 (UART_RTS_N); also elsewhere on the board
/Application/HCI_RTS: R404.1, U401.44 (UART_CTS_N); also elsewhere on the board
/Application/HCI_RX: R402.2, U401.42 (UART_TXD); also elsewhere on the board
/Application/HCI_TX: R403.2, U401.43 (UART_RXD); also elsewhere on the board
/Application/SUS_CLK: R457.1; also elsewhere on the board
/Application/WIFI_CLK: U401.17 (SDIO_DATA_CLK); also elsewhere on the board
/Application/WIFI_CMD: R451.2, U401.16 (SDIO_DATA_CMD); also elsewhere on the board
/Application/WIFI_DAT0: R452.2, U401.18 (SDIO_DATA_0); also elsewhere on the board
/Application/WIFI_DAT1: R453.2, U401.19 (SDIO_DATA_1); also elsewhere on the board
/Application/WIFI_DAT2: R454.2, U401.14 (SDIO_DATA_2); also elsewhere on the board
/Application/WIFI_DAT3: R455.2, U401.15 (SDIO_DATA_3); also elsewhere on the board
/Application/WL_REG_ON: R450.2, U401.12 (WL_REG_ON); also elsewhere on the board
/Application/WL_WAKE_AP: U401.13 (WL_HOST_WAKE); also elsewhere on the board
/RL-SM02BD-8723BS/ANT: ANT401.1, C428.1, R405.1
/RL-SM02BD-8723BS/ANT_FILT: C427.1, R405.2, U401.2 (WL_BT_ANT)
/RL-SM02BD-8723BS/LPO: R457.2, R458.1, U401.24 (LPO)
/RL-SM02BD-8723BS/VDD_WIFI: C415.1, C416.1, R401.1, R402.1, R403.1, R404.2, R450.1, R451.1, R452.1, R453.1, R454.1, R455.1, R456.1, R458.2, R461.2, U401.9 (VBAT), U401.22 (VDDIO)
/RL-SM02BD-8723BS/VIN_LDO: C429.1, L403.1, U401.23 (VIN_LDO)
/RL-SM02BD-8723BS/XI: C402.1, U401.10 (XTAL_IN), Y401.1
/RL-SM02BD-8723BS/XO: C414.1, U401.11 (XTAL_OUT), Y401.3
GND: ANT401.2, ANT401.3, C402.2, C414.2, C415.2, C416.2, C427.2, C428.2, C429.2, R460.1, U401.1 (GND), U401.3 (GND), U401.20 (GND), U401.31 (GND), U401.33 (GND), U401.36 (GND), Y401.2, Y401.4; also elsewhere on the board
unnamed: L403.2, U401.21 (VIN_LDO_OUT)

Notes on the sheet:
CX1 = CX2 = 2(15pF - 2pF) = 26pF 22pF already in the bom
