ConnorRigby/underglow3/MainBoard/underglow3.kicad_pcb

## KiCad design MainBoard/underglow3.kicad_pcb (continued)

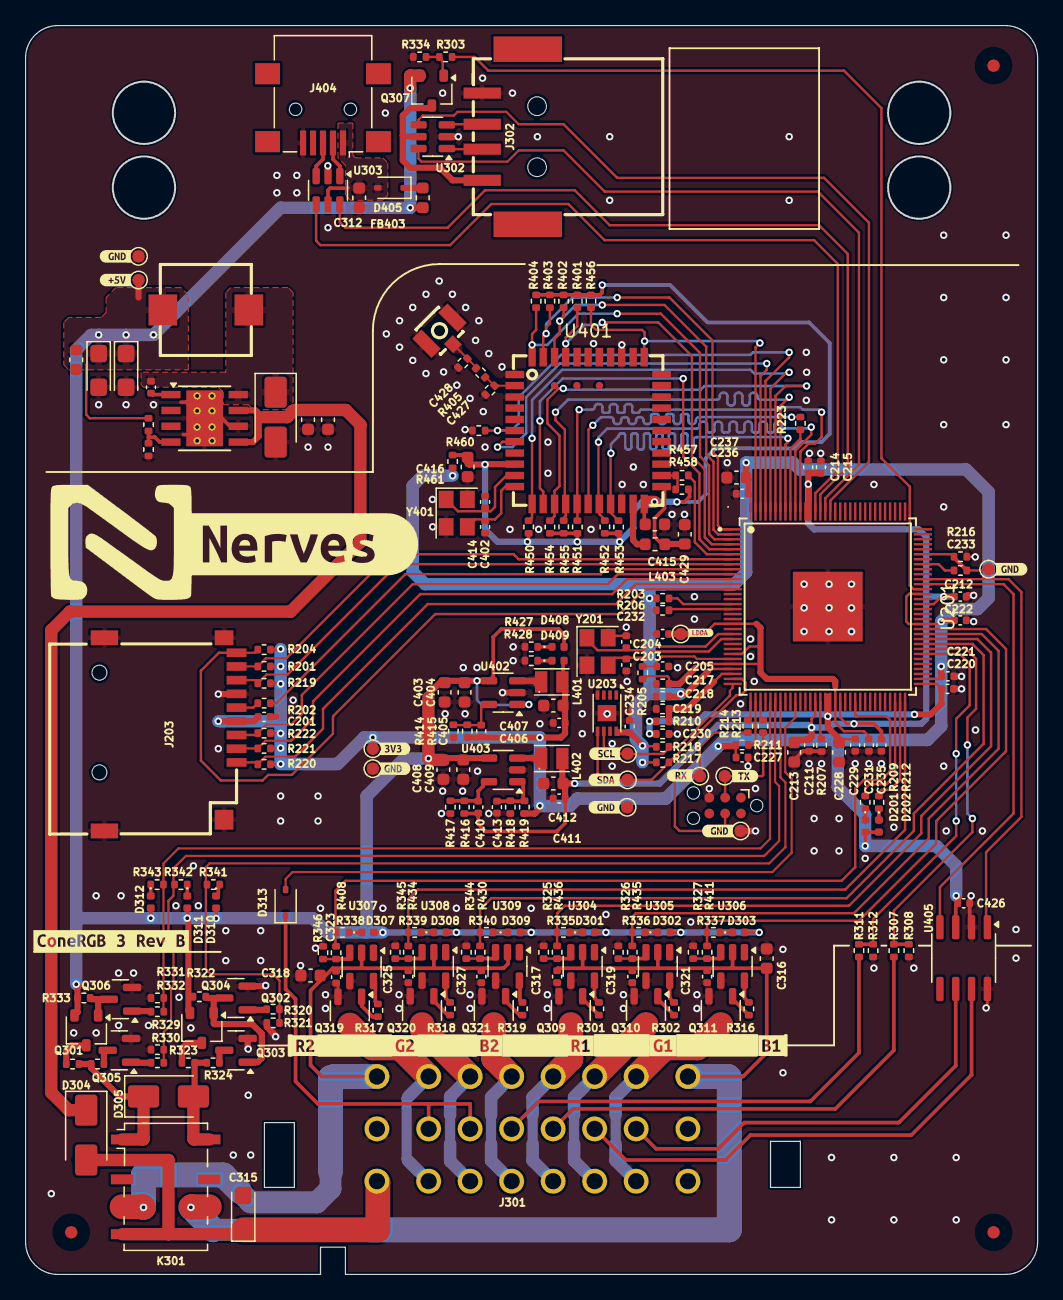
[picture p17: board underglow3.kicad_pcb from above]

Board: 4 copper layers, 81.2 x 100.2 mm, 246 parts (0 on the bottom side), 145 nets.

Other parts of the board:
Enclosure: TestPoint_Pad_D1.0mm
TP: GND; TestPoint_Pad_D1.0mm
TP#2: GND; TestPoint_Pad_D1.0mm
U201: T113-S3; LQFP-128_L14.0-W14.0-P0.40-LS16.0-BL-EP5.6
kibuzzard-65F09AC9: G***; kibuzzard-65F09AC9
kibuzzard-65F09B04: G***; kibuzzard-65F09B04
kibuzzard-65F09B16: G***; kibuzzard-65F09B16
kibuzzard-65F09B27: G***; kibuzzard-65F09B27
kibuzzard-65F09B40: G***; kibuzzard-65F09B40
kibuzzard-65F09B51: G***; kibuzzard-65F09B51
kibuzzard-65F09C6B: G***; kibuzzard-65F09C6B
kibuzzard-65F09CD2: G***; kibuzzard-65F09CD2
kibuzzard-65F09CF9: G***; kibuzzard-65F09CF9
kibuzzard-65F09D0C: G***; kibuzzard-65F09D0C
kibuzzard-65F09D1C, kibuzzard-65F09D1C#2: G***; kibuzzard-65F09D1C
kibuzzard-65FE52BD: G***; kibuzzard-65FE52BD
kibuzzard-65FE522B: G***; kibuzzard-65FE522B
kibuzzard-65FEF020: G***; kibuzzard-65FEF020
kibuzzard-65FEF408: G***; kibuzzard-65FEF408
kibuzzard-65FEF568: G***; kibuzzard-65FEF568
kibuzzard-666C6B51: G***; kibuzzard-666C6B51
kibuzzard-6669C582: G***; kibuzzard-6669C582
kibuzzard-6669C587: G***; kibuzzard-6669C587

Their connections:
+0v9: U201.46 (VDD-SYS0), U201.51 (VDD-SYS0), U201.81 (VDD-SYS2), U201.116 (VDD-CORE0), U201.117 (VDD-CORE1); also elsewhere on the board
+1V8A: U201.89 (AVCC); also elsewhere on the board
+3V3: U201.29 (LDO-IN), U201.66 (VCC-PD), U201.77 (VCC-TVOUT), U201.83 (VCC-IO), U201.128 (VCC-PG); also elsewhere on the board
/Application/AP_WAKE_BT: U201.125 (PG13); also elsewhere on the board
/Application/BT_EN: U201.127 (PG15); also elsewhere on the board
/Application/BT_WAKE_AP: U201.126 (PG14); also elsewhere on the board
/Application/CAN0_RX: U201.85 (PB3); also elsewhere on the board
/Application/CAN0_TX: U201.86 (PB2); also elsewhere on the board
/Application/DZQ: U201.47 (DZQ); also elsewhere on the board
/Application/HCI_CTS: U201.4 (PG9); also elsewhere on the board
/Application/HCI_RTS: U201.3 (PG8); also elsewhere on the board
/Application/HCI_RX: U201.2 (PG7); also elsewhere on the board
/Application/HCI_TX: U201.1 (PG6); also elsewhere on the board
/Application/I2C_SCL: U201.32 (PE12); also elsewhere on the board
/Application/I2C_SDA: U201.31 (PE13); also elsewhere on the board
/Application/LDOA_OUT: U201.20 (VCC-PLL), U201.26 (VCC-RTC), U201.28 (LDOA-OUT), U201.50 (VDD18-DRAM); also elsewhere on the board
/Application/LDOB_OUT: U201.30 (LDOB-OUT); also elsewhere on the board
/Application/LEDC: U201.42 (PE5); also elsewhere on the board
/Application/LED_ST1: U201.62 (PD7); also elsewhere on the board
/Application/LED_ST2: U201.63 (PD8); also elsewhere on the board
/Application/PWM0: U201.73 (PD16); also elsewhere on the board
/Application/PWM1: U201.74 (PD17); also elsewhere on the board
/Application/PWM2: U201.75 (PD18); also elsewhere on the board
/Application/PWM3: U201.76 (PD19); also elsewhere on the board
/Application/PWM4: U201.54 (PD20); also elsewhere on the board
/Application/PWM6: U201.64 (PD9); also elsewhere on the board
/Application/RELAY_COIL_GND: U201.38 (PE9); also elsewhere on the board
/Application/RELAY_COIL_VDC: U201.37 (PE10); also elsewhere on the board
/Application/RELAY_SW: U201.39 (PE8); also elsewhere on the board
/Application/RST: U201.27 (RST); also elsewhere on the board
/Application/SDCO0_CLK: U201.9 (PF2); also elsewhere on the board
/Application/SDCO0_CMD: U201.10 (PF3); also elsewhere on the board
/Application/SDCO0_D0: U201.8 (PF1); also elsewhere on the board
/Application/SDCO0_D1: U201.7 (PF0); also elsewhere on the board
/Application/SDCO0_D2: U201.12 (PF5); also elsewhere on the board
/Application/SDCO0_D3: U201.11 (PF4); also elsewhere on the board
/Application/SD_DET: U201.13 (PF6); also elsewhere on the board
/Application/SPI0_CLK: U201.19 (PC2); also elsewhere on the board
/Application/SPI0_CS0: U201.18 (PC3); also elsewhere on the board
/Application/SPI0_HLD: U201.14 (PC7); also elsewhere on the board
/Application/SPI0_MISO: U201.16 (PC5); also elsewhere on the board
/Application/SPI0_MOSI: U201.17 (PC4); also elsewhere on the board
/Application/SPI0_WP: U201.15 (PC6); also elsewhere on the board
/Application/SUS_CLK: U201.6 (PG11); also elsewhere on the board
/Application/UART0_RX: U201.33 (PE3); also elsewhere on the board
/Application/UART0_TX: U201.35 (PE2); also elsewhere on the board
/Application/USB_SW: U201.84 (PB4); also elsewhere on the board
/Application/VCC_DRAM: U201.48 (VCC-DRAM0), U201.49 (VCC-DRAM1), U201.65 (VCC-LVDS); also elsewhere on the board
/Application/VCC_PE: U201.34 (VCC-PE); also elsewhere on the board
/Application/WIFI_CMD: U201.118 (PG1); also elsewhere on the board
/Application/WIFI_DAT0: U201.119 (PG2); also elsewhere on the board
/Application/WIFI_DAT1: U201.121 (PG3); also elsewhere on the board
/Application/WIFI_DAT2: U201.123 (PG4); also elsewhere on the board
/Application/WIFI_DAT3: U201.122 (PG5); also elsewhere on the board
/Application/WL_REG_ON: U201.124 (PG12); also elsewhere on the board
/Application/WL_WAKE_AP: U201.5 (PG10); also elsewhere on the board
/Application/XI: U201.23 (DXIN); also elsewhere on the board
/Application/XO: U201.22 (DXOUT); also elsewhere on the board
/Power/PI1_DIV: U201.72 (PD15); also elsewhere on the board
/Power/PI2_DIV: U201.71 (PD14); also elsewhere on the board
/Power/USB0_DN: U201.114 (USB0-DM); also elsewhere on the board
/Power/USB0_DP: U201.115 (USB0-DP); also elsewhere on the board
/Power/USB1_DN: U201.113 (USB1-DM); also elsewhere on the board
/Power/USB1_DP: U201.112 (USB1-DP); also elsewhere on the board
GND: TP.1, TP#2.1, U201.129 (EP); also elsewhere on the board
GNDA: U201.91 (AGND); also elsewhere on the board
unnamed 130: U201.120 (PG0); also elsewhere on the board
