ConnorRigby/underglow3/(commit log)

2024-02-15 Initial commit, submitted for fab
    [ESP32-WROOM-32U-N4.kicad_sch, Enclosure-Assembly.FCStd, Enclosure-Top.FCStd, MYB-YT113X-V10-bottom.dxf, MYB-YT113X-V10-top.dxf, MYB-YT113X-V10.DSN, MYC-T113i Pin list_V1.0.xlsx, MYC-YT113X Pin List V1.0.xlsx]
2024-03-14 submit for production at jlc
    [BOM-underglow3.csv, ESP32-WROOM-32U-N4.kicad_sch, Enclosure-Assembly.FCStd, Enclosure-Top.FCStd, MYB-YT113X-V10-bottom.dxf, MYB-YT113X-V10-top.dxf, MYB-YT113X-V10.DSN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]
2024-03-23 Submit for fab rev 2
    [BOM-underglow3.csv, Power.kicad_sch, RL-SM02BD-8723BS.kicad_sch, Simulation.kicad_pcb, Simulation.kicad_sch, T113-S3.kicad_sch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]
2024-06-18 Submit for production
    [BOM-underglow3.csv, Power.kicad_sch, RL-SM02BD-8723BS.kicad_sch, T113-S3.kicad_sch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]
2024-08-10 Remove unused support directory
    [MYB-YT113X-V10-bottom.dxf, MYB-YT113X-V10-top.dxf, MYB-YT113X-V10.DSN, MYC-T113i Pin list_V1.0.xlsx, MYC-YT113X Pin List V1.0.xlsx, sim.kicad_pcb, sim.kicad_sch]
2024-08-10 Doc updates
    [index.bom.tsv, underglow3.kicad_pcb]
